sfrwmaker/TFT_Rework_station/title.JPG

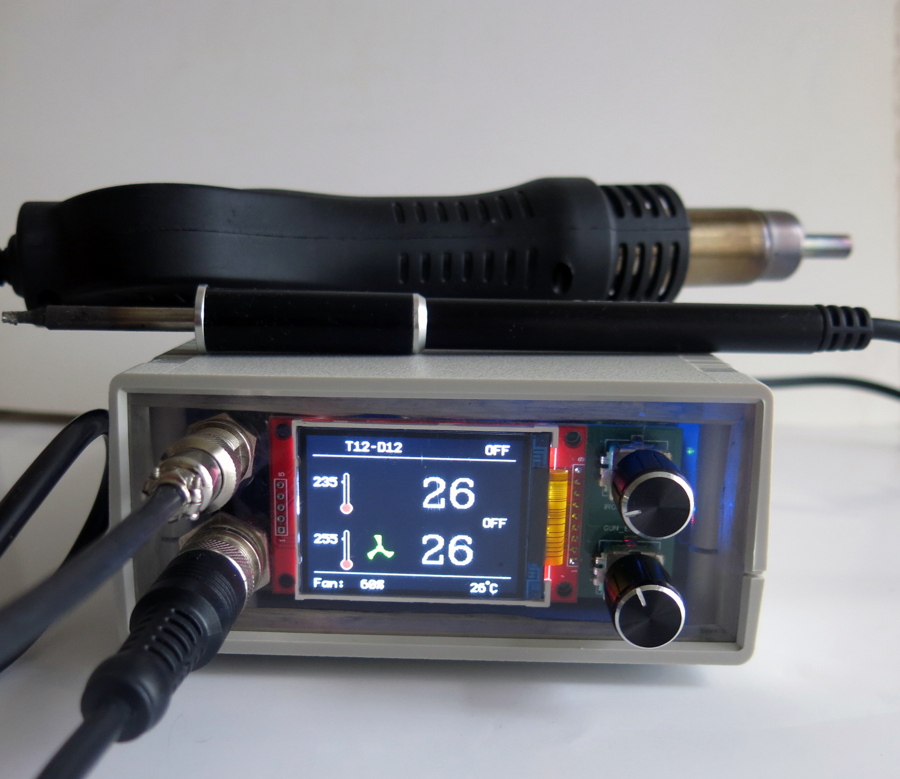
title.JPG
