sfrwmaker/TFT_Rework_station/SRC/W25Qxx/README

This is a library to manage W24Qxx flash SPI ICs.
