sfrwmaker/TFT_Rework_station/SRC/SD_SPI/README

This is a library to manage SD-cards connected via SPI bus.
