sfrwmaker/TFT_Rework_station/ctrl.png

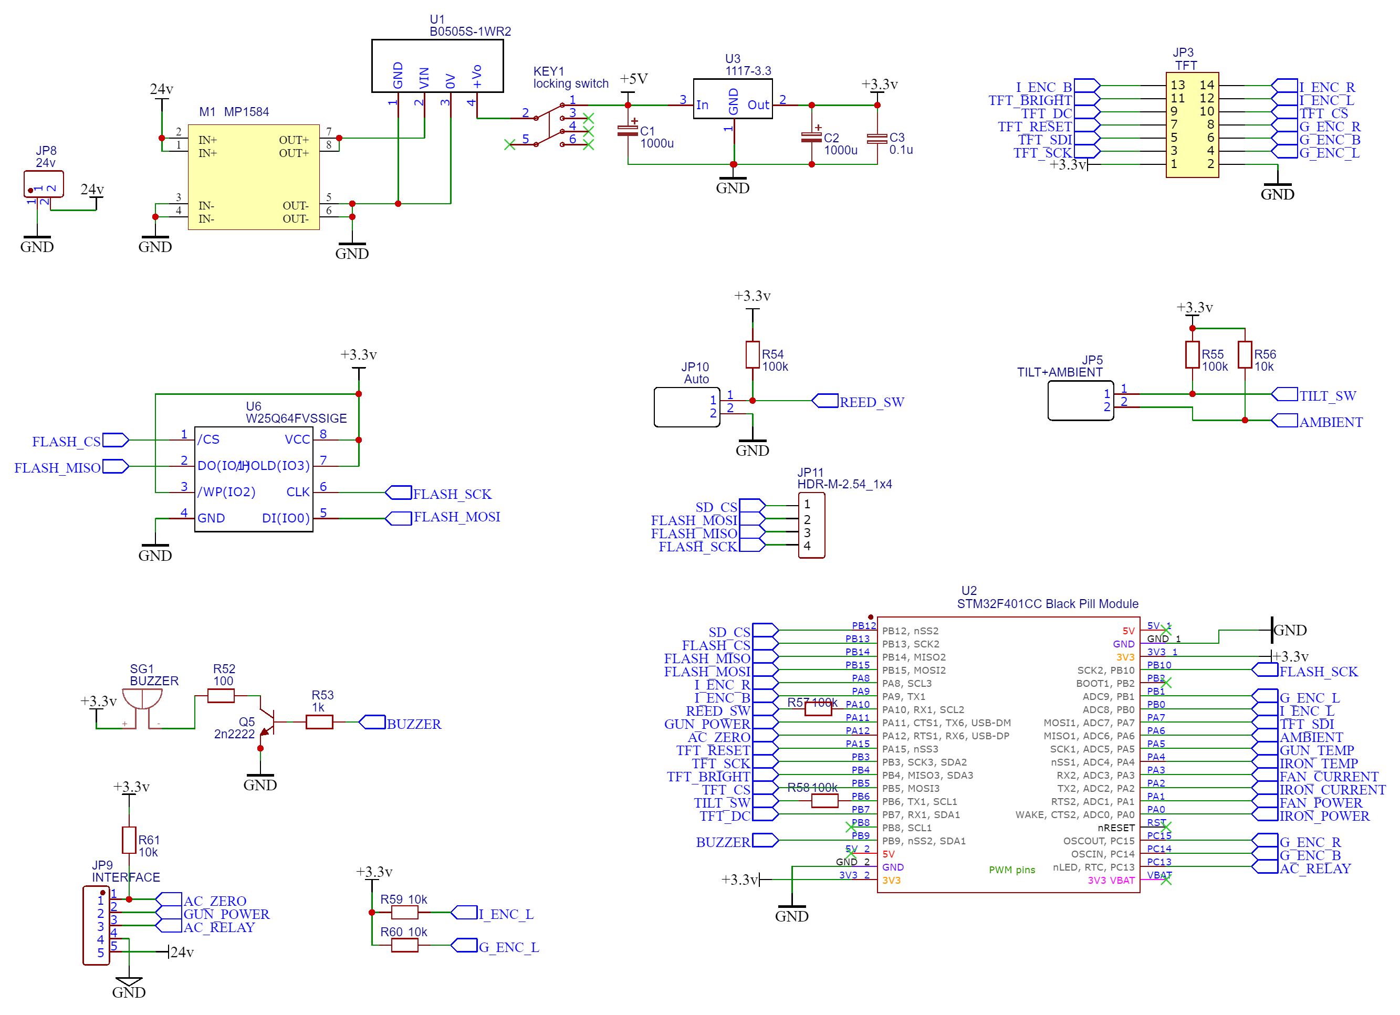
ctrl.png
