sfrwmaker/TFT_Rework_station/high_voltage.png

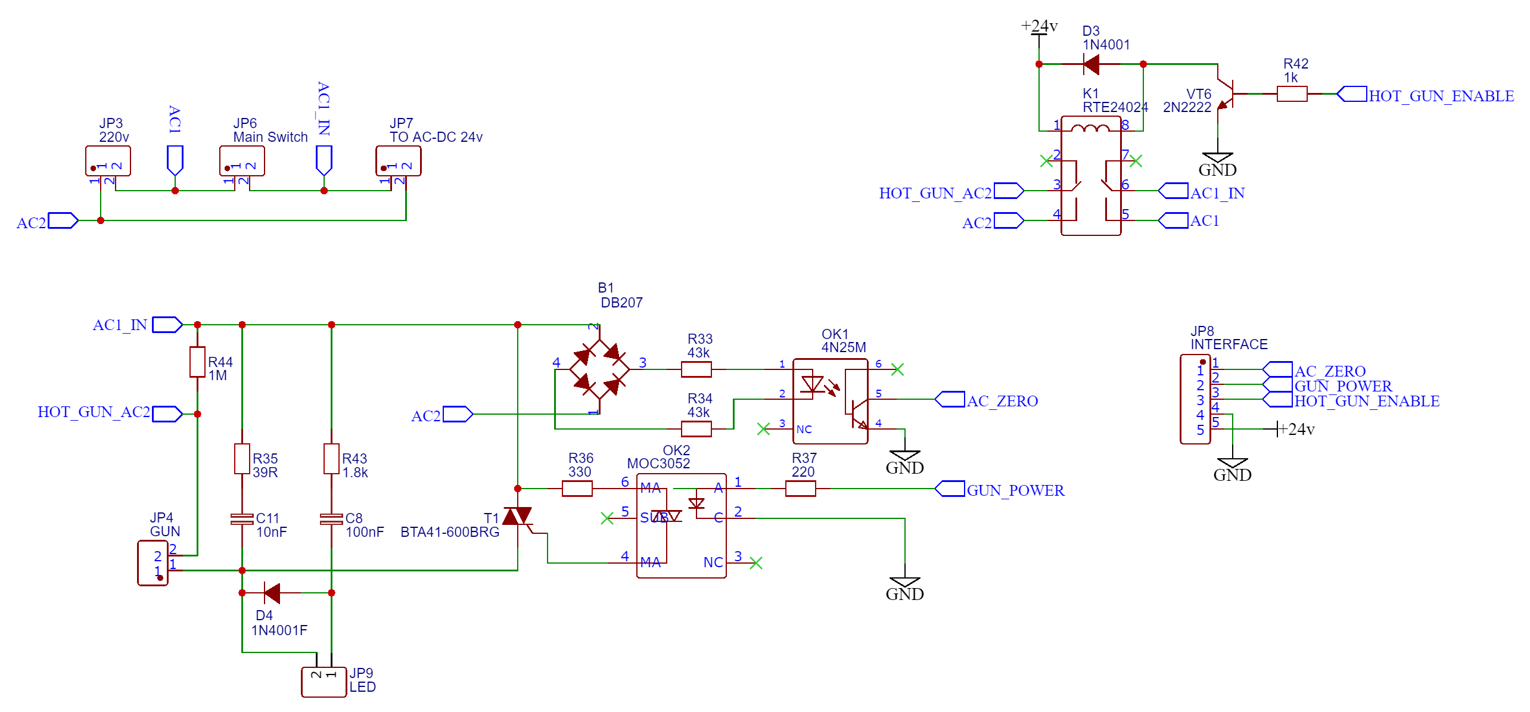
high_voltage.png
