sfrwmaker/TFT_Rework_station/iron_sensors.png

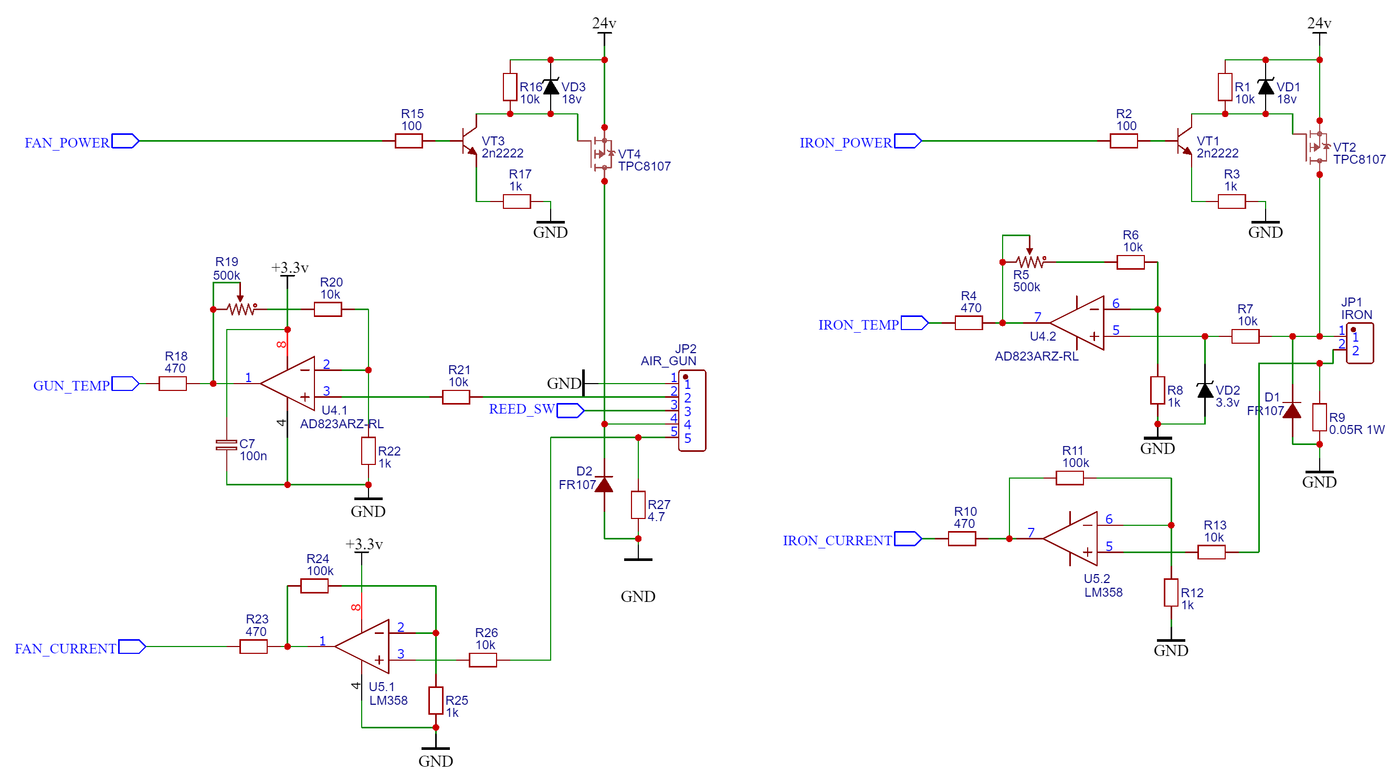
iron_sensors.png
