sfrwmaker/TFT_Rework_station/tft_board.png

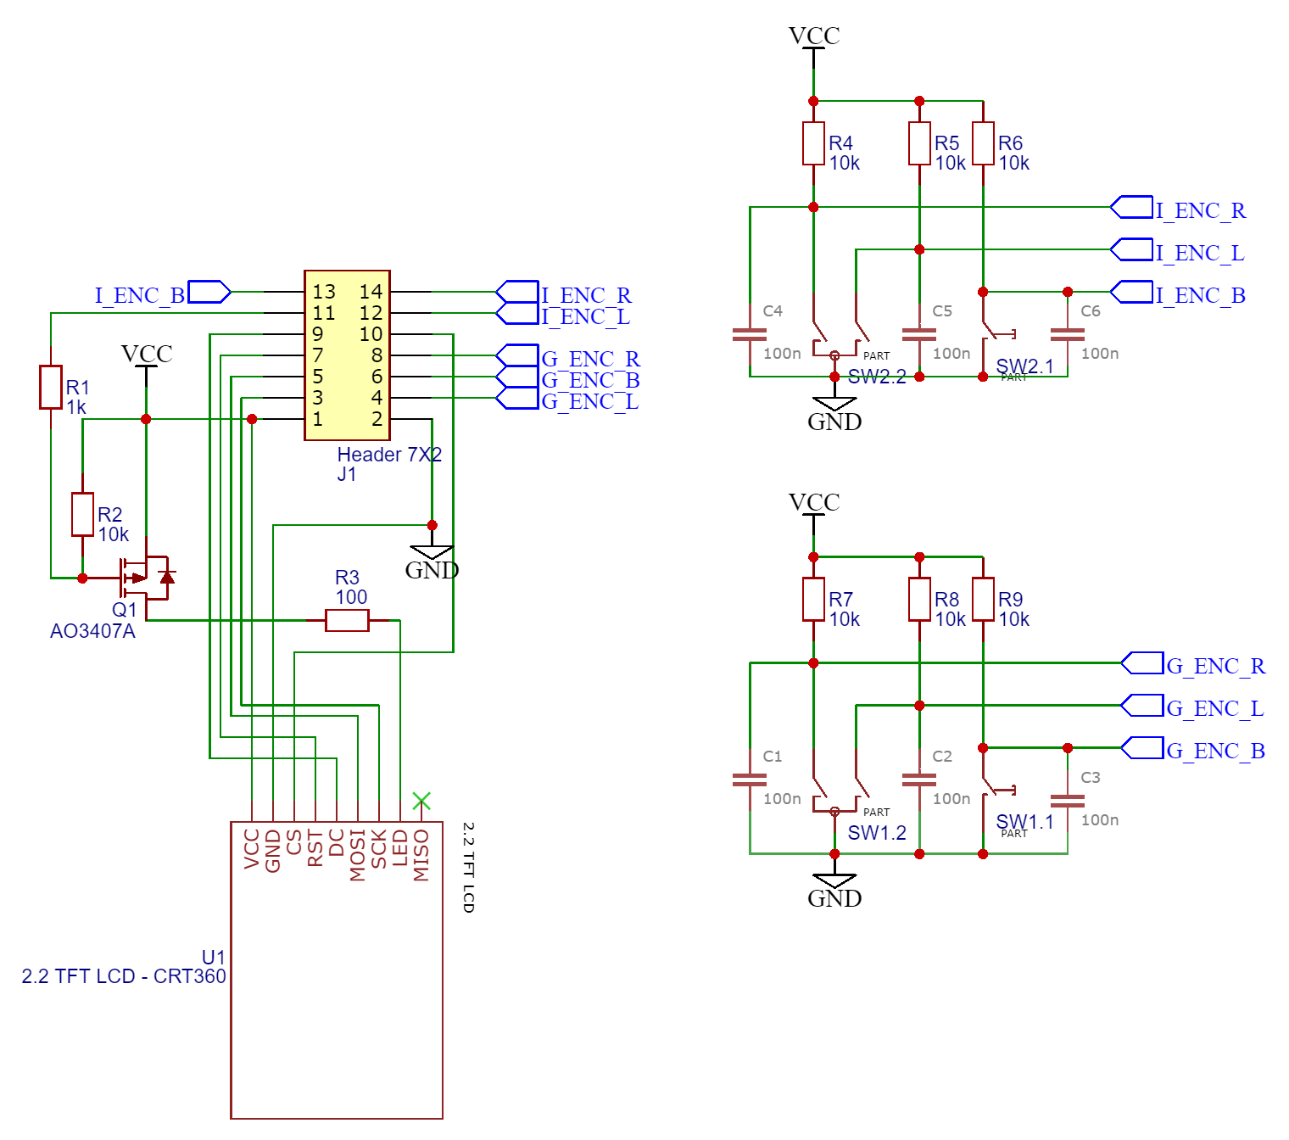
tft_board.png
