sfrwmaker/TFT_Rework_station/(threads)

Thread 1 (2021-11-21):

Questions to discuss the safety feature

zanfi2010, 2021-11-21:
Hello Alexander:

I can't sign up the www.hackster.io, so I leave the messages here.

Your project is great and I'm studying it.

There are some questions to discuss the safety feature. Safety is the first. Some idears from me, please correct me if my understandings are wrong.

1. If the relay K1 is OFF but the Main switch is ON, the power still deliver to GX16.
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

Maybe we can use two relays. relay K1 to used to cut off the power to GX16, and relay K2 be used to automaticslly turn-off the power after the Main switch is off. And it need the second control signal named “HOT_GUN_ENABLE_2” below.
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

For further, we can connect the triode VT6‘s emitter to GND on Air Gun handle. When the GX16 is removed, the relay K1 will be turn off automatically even if the MCU fails. Then it need nine pins aviation plug and can be got from online shop.
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

Maybe it can be simplified:
a. Use one relay with 11 pins(U10);
b. Use Bidirectional Optocoupler(U11);
c. Use zero-cross optoisolators triac driver(U12), and I think that the U11 can be simplified too.
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

2. The GX16 can be used another type as below. I think it will be more safety.
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

I'm copying you project, welcome to: https://oshwhub.com/zanfi1010/stm32_rework_tft

sfrwmaker, 2021-11-23:
First of all, you are right! It is not completely safe. When the relay was introduced in the project, it operates on both AC lines, N and L. Then somebody asked to introduce the 'delayed power-off' feature and i thought that two relays are too much. :) So, i managed one line via relay and another via the TRIAC, as you can see. The path you have highlighted goes through 1Mohm resistor R44. I do believe nobody will be hurted through it. And yes, it is nice to replace the socket also. Or you can use another relay with 3 or 4 contacts.
This project was create to inspire people for good ideas first of all. :)

zanfi2010, 2021-11-24:
I'll try part of my ideas in my duplicate project.
Thanka a lot!

Closed 2021-11-26.
