sfrwmaker/TFT_Rework_station/SRC/Core/Inc/main.h

#define AC_RELAY_Pin GPIO_PIN_13
#define AC_RELAY_GPIO_Port GPIOC
#define G_ENC_B_Pin GPIO_PIN_14
#define G_ENC_B_GPIO_Port GPIOC
#define G_ENC_R_Pin GPIO_PIN_15
#define G_ENC_R_GPIO_Port GPIOC
#define IRON_POWER_Pin GPIO_PIN_0
#define IRON_POWER_GPIO_Port GPIOA
#define FAN_POWER_Pin GPIO_PIN_1
#define FAN_POWER_GPIO_Port GPIOA
#define IRON_CURRENT_Pin GPIO_PIN_2
#define IRON_CURRENT_GPIO_Port GPIOA
#define FAN_CURRENT_Pin GPIO_PIN_3
#define FAN_CURRENT_GPIO_Port GPIOA
#define IRON_TEMP_Pin GPIO_PIN_4
#define IRON_TEMP_GPIO_Port GPIOA
#define GUN_TEMP_Pin GPIO_PIN_5
#define GUN_TEMP_GPIO_Port GPIOA
#define AMBIENT_Pin GPIO_PIN_6
#define AMBIENT_GPIO_Port GPIOA
#define TFT_SDI_Pin GPIO_PIN_7
#define TFT_SDI_GPIO_Port GPIOA
#define I_ENC_L_Pin GPIO_PIN_0
#define I_ENC_L_GPIO_Port GPIOB
#define I_ENC_L_EXTI_IRQn EXTI0_IRQn
#define G_ENC_L_Pin GPIO_PIN_1
#define G_ENC_L_GPIO_Port GPIOB
#define G_ENC_L_EXTI_IRQn EXTI1_IRQn
#define FLASH_SCK_Pin GPIO_PIN_10
#define FLASH_SCK_GPIO_Port GPIOB
#define SD_CS_Pin GPIO_PIN_12
#define SD_CS_GPIO_Port GPIOB
#define FLASH_CS_Pin GPIO_PIN_13
#define FLASH_CS_GPIO_Port GPIOB
#define FLASH_MISO_Pin GPIO_PIN_14
#define FLASH_MISO_GPIO_Port GPIOB
#define FLASH_MOSI_Pin GPIO_PIN_15
#define FLASH_MOSI_GPIO_Port GPIOB
#define I_ENC_R_Pin GPIO_PIN_8
#define I_ENC_R_GPIO_Port GPIOA
#define I_ENC_B_Pin GPIO_PIN_9
#define I_ENC_B_GPIO_Port GPIOA
#define REED_SW_Pin GPIO_PIN_10
#define REED_SW_GPIO_Port GPIOA
#define GUN_POWER_Pin GPIO_PIN_11
#define GUN_POWER_GPIO_Port GPIOA
#define AC_ZERO_Pin GPIO_PIN_12
#define AC_ZERO_GPIO_Port GPIOA
#define TFT_RESET_Pin GPIO_PIN_15
#define TFT_RESET_GPIO_Port GPIOA
#define TFT_SCK_Pin GPIO_PIN_3
#define TFT_SCK_GPIO_Port GPIOB
#define TFT_BRIGHT_Pin GPIO_PIN_4
#define TFT_BRIGHT_GPIO_Port GPIOB
#define TFT_CS_Pin GPIO_PIN_5
#define TFT_CS_GPIO_Port GPIOB
#define TILT_SW_Pin GPIO_PIN_6
#define TILT_SW_GPIO_Port GPIOB
#define TFT_DC_Pin GPIO_PIN_7
#define TFT_DC_GPIO_Port GPIOB
#define BUZZER_Pin GPIO_PIN_9
#define BUZZER_GPIO_Port GPIOB
#define FW_VERSION	("1.15")
