sfrwmaker/TFT_Rework_station/SRC/TFT/gamma.c

/*
 * gamma.c
 *
 *  Created on: 21 May, 2024
 *      Author: Alex
 */

#include "gamma.h"
#include "config.h"
#include "interface.h"

#ifdef APPLY_GAMMA_PROFILE

typedef enum {
	CMD_GAMMA_D1		= 0xD1,
	CMD_GAMMA_D2		= 0xD2,
	CMD_GAMMA_D3		= 0xD3,
	CMD_GAMMA_D4		= 0xD4,
	CMD_GAMMA_D5		= 0xD5,
	CMD_GAMMA_D6		= 0xD6,
} GAMMA_CMD;

void TFT_Gamma_NT35510(void) {
	static const uint8_t g1[52] = { 0x00, 0x37, 0x00, 0x52, 0x00, 0x7B, 0x00, 0x99, 0x00, 0xB1,
									0x00, 0xD2,	0x00, 0xF6,	0x01, 0x27,	0x01, 0x4E,	0x01, 0x8C,
									0x01, 0xBE, 0x02, 0x0B, 0x02, 0x48, 0x02, 0x4A, 0x02, 0x7E,
									0x02, 0xBC, 0x02, 0xE1, 0x03, 0x10, 0x03, 0x31, 0x03, 0x5A,
									0x03, 0x73, 0x03, 0x94, 0x03, 0x9F,	0x03, 0xB3, 0x03, 0xB9, 0x03, 0xC1 };
	static const uint8_t g2[52] = { 0x00, 0x37, 0x00, 0x52, 0x00, 0x7B, 0x00, 0x99, 0x00, 0xB1,
									0x00, 0xD2, 0x00, 0xF6, 0x01, 0x27, 0x01, 0x4E, 0x01, 0x8C,
									0x01, 0xBE, 0x02, 0x0B, 0x02, 0x48, 0x02, 0x4A, 0x02, 0x7E,
									0x02, 0xBC, 0x02, 0xE1, 0x03, 0x10, 0x03, 0x31, 0x03, 0x5A,
									0x03, 0x73, 0x03, 0x94, 0x03, 0x9F, 0x03, 0xB3, 0x03, 0xB9, 0x03, 0xC1 };
	static const uint8_t g3[52] = { 0x00, 0x37, 0x00, 0x52, 0x00, 0x7B, 0x00, 0x99, 0x00, 0xB1,
									0x00, 0xD2, 0x00, 0xF6, 0x01, 0x27, 0x01, 0x4E, 0x01, 0x8C,
									0x01, 0xBE, 0x02, 0x0B, 0x02, 0x48, 0x02, 0x4A, 0x02, 0x7E,
									0x02, 0xBC, 0x02, 0xE1, 0x03, 0x10, 0x03, 0x31, 0x03, 0x5A,
									0x03, 0x73, 0x03, 0x94, 0x03, 0x9F, 0x03, 0xB3, 0x03, 0xB9, 0x03, 0xC1};
	static const uint8_t g4[52] = { 0x00, 0x37, 0x00, 0x52, 0x00, 0x7B, 0x00, 0x99, 0x00, 0xB1,
									0x00, 0xD2, 0x00, 0xF6, 0x01, 0x27, 0x01, 0x4E, 0x01, 0x8C,
									0x01, 0xBE, 0x02, 0x0B, 0x02, 0x48, 0x02, 0x4A, 0x02, 0x7E,
									0x02, 0xBC, 0x02, 0xE1, 0x03, 0x10, 0x03, 0x31, 0x03, 0x5A,
									0x03, 0x73, 0x03, 0x94, 0x03, 0x9F, 0x03, 0xB3, 0x03, 0xB9, 0x03, 0xC1};
	static const uint8_t g5[52] = { 0x00, 0x37, 0x00, 0x52, 0x00, 0x7B, 0x00, 0x99, 0x00, 0xB1,
									0x00, 0xD2, 0x00, 0xF6, 0x01, 0x27, 0x01, 0x4E, 0x01, 0x8C,
									0x01, 0xBE, 0x02, 0x0B, 0x02, 0x48, 0x02, 0x4A, 0x02, 0x7E,
									0x02, 0xBC, 0x02, 0xE1, 0x03, 0x10, 0x03, 0x31, 0x03, 0x5A,
									0x03, 0x73, 0x03, 0x94, 0x03, 0x9F, 0x03, 0xB3, 0x03, 0xB9, 0x03, 0xC1};
	static const uint8_t g6[52] = { 0x00, 0x37, 0x00, 0x52, 0x00, 0x7B, 0x00, 0x99, 0x00, 0xB1,
									0x00, 0xD2, 0x00, 0xF6, 0x01, 0x27, 0x01, 0x4E, 0x01, 0x8C,
									0x01, 0xBE, 0x02, 0x0B, 0x02, 0x48, 0x02, 0x4A, 0x02, 0x7E,
									0x02, 0xBC, 0x02, 0xE1, 0x03, 0x10, 0x03, 0x31, 0x03, 0x5A,
									0x03, 0x73, 0x03, 0x94, 0x03, 0x9F, 0x03, 0xB3, 0x03, 0xB9, 0x03, 0xC1};

	TFT_Command(CMD_GAMMA_D1,	g1, 52);
	TFT_Command(CMD_GAMMA_D2,	g2, 52);
	TFT_Command(CMD_GAMMA_D3,	g3, 52);
	TFT_Command(CMD_GAMMA_D4,	g4, 52);
	TFT_Command(CMD_GAMMA_D5,	g5, 52);
	TFT_Command(CMD_GAMMA_D6,	g6, 52);
}

#endif
